pres2300/ToiletMonitor/(commit log)

2023-11-25 Loop to detect water, alarm if not present, turn off alarm if button pressed
2023-11-26 Ain’t need no float
2023-11-26 Lowering ADC count threshold
